nhaynes84/murmur/cad/back-pass2.png

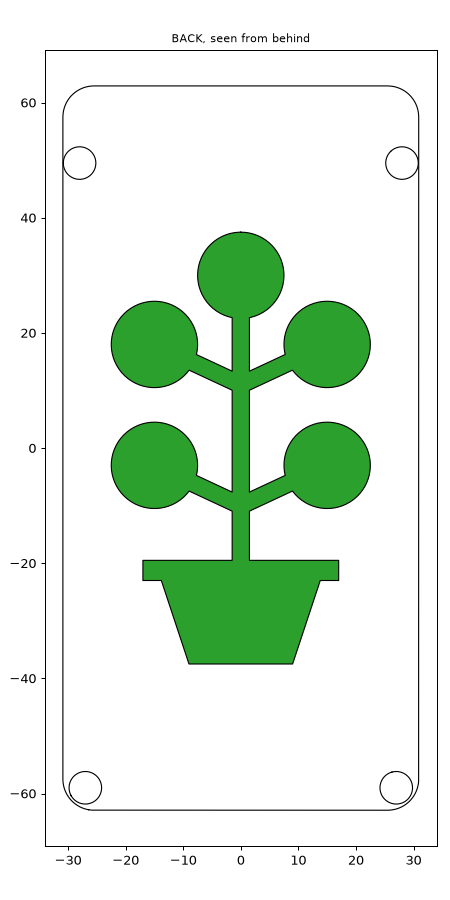
cad/back-pass2.png
