nhaynes84/murmur/cad/face-pass2.png

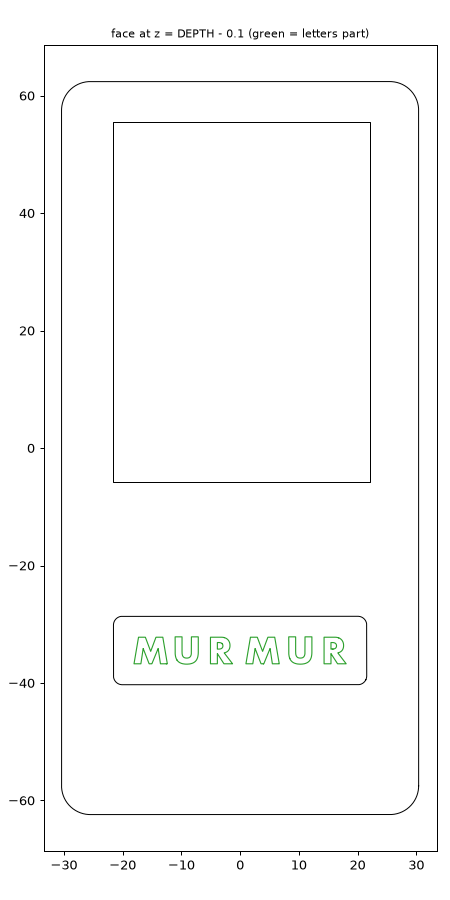
cad/face-pass2.png
