nhaynes84/murmur/cad/plan-pass2.png

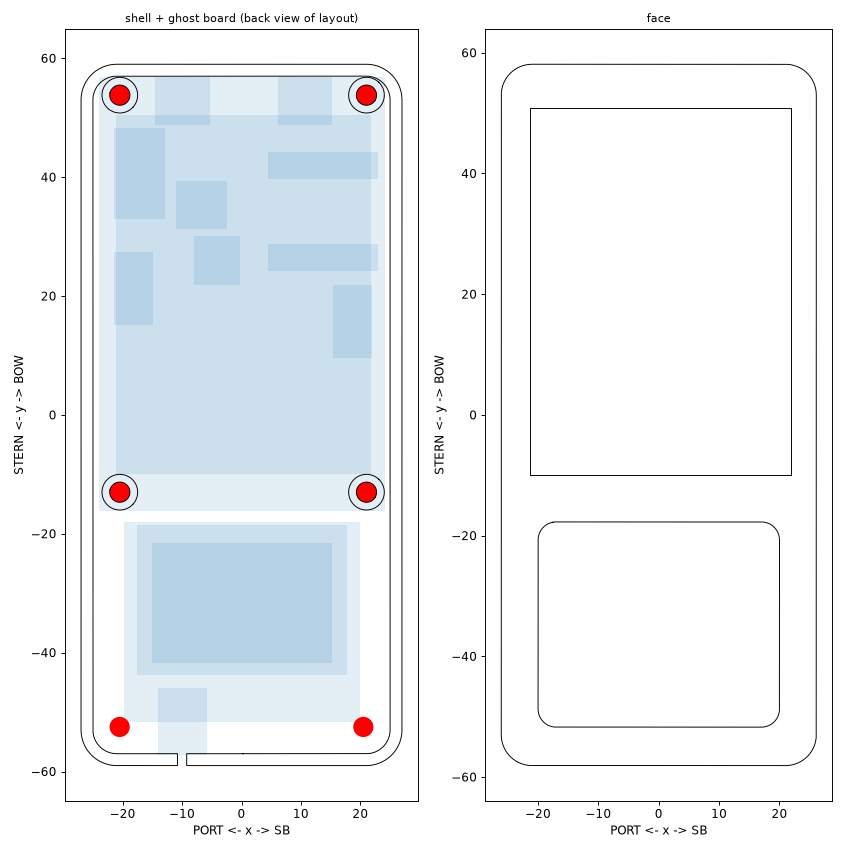
cad/plan-pass2.png
