nhaynes84/murmur/cad/port-pass2.png

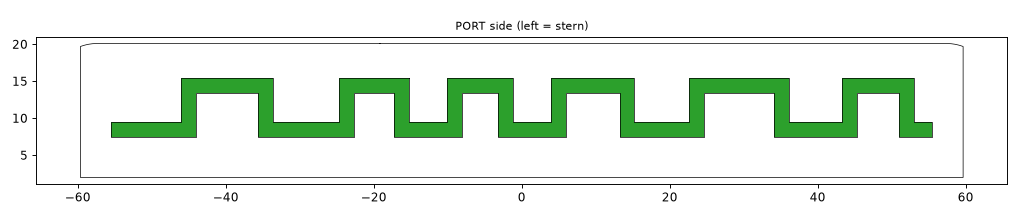
cad/port-pass2.png
