nhaynes84/murmur/cad/sides-pass2.png

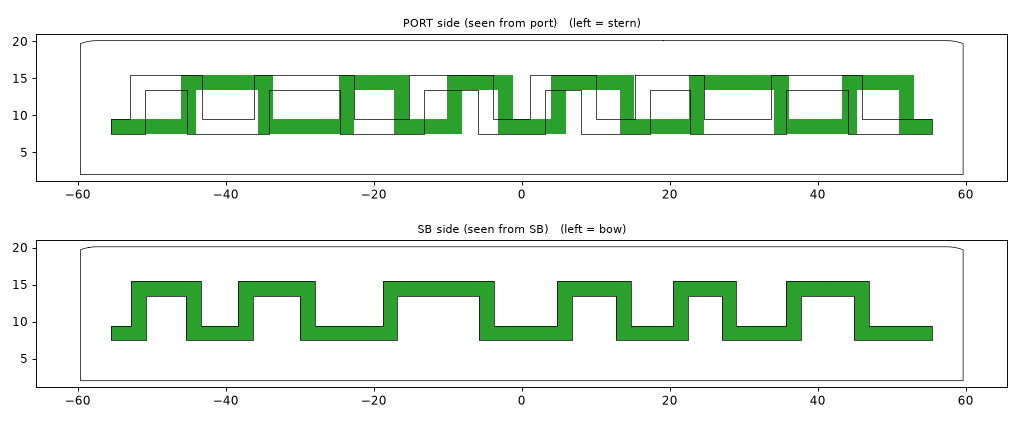
cad/sides-pass2.png
