nhaynes84/murmur/docs/murmur-schematic.png

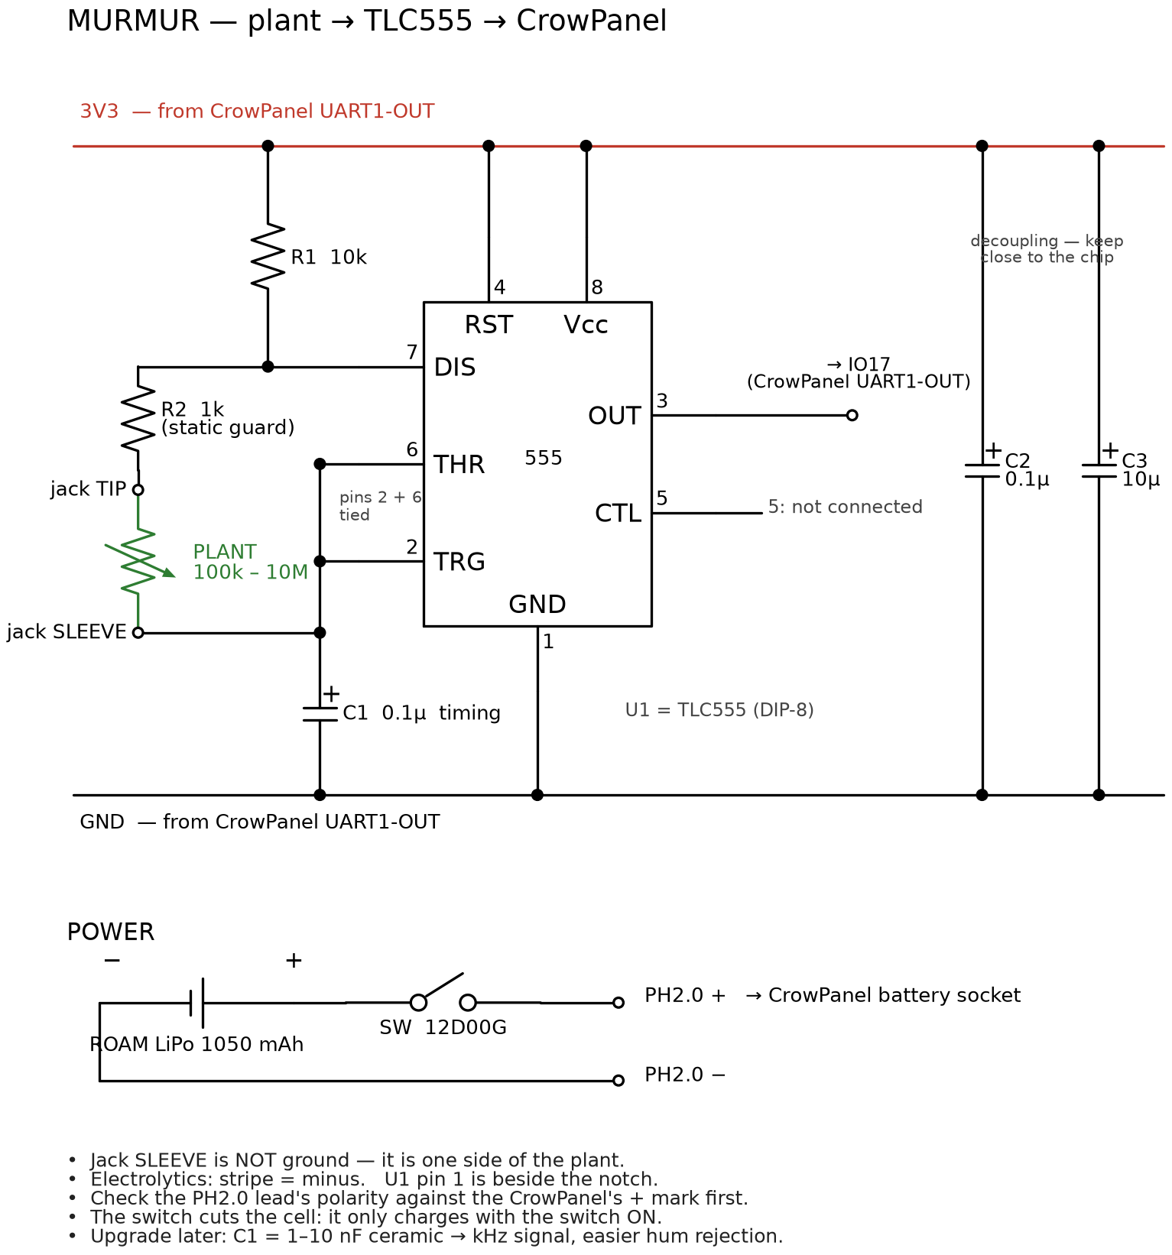
docs/murmur-schematic.png
