nhaynes84/murmur/docs/screens/main.png

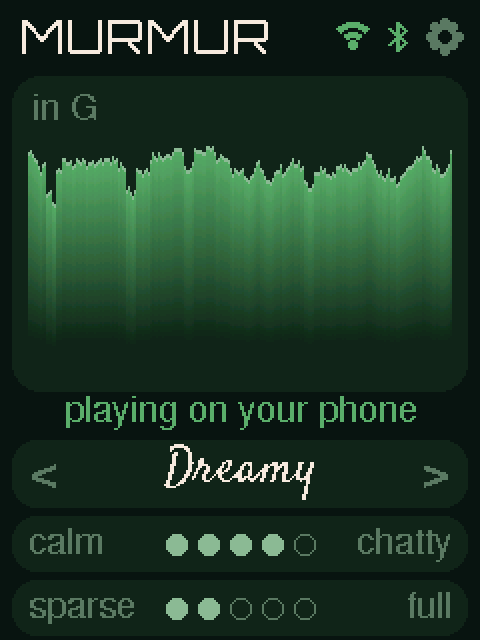
docs/screens/main.png
