nhaynes84/murmur/prints/murmur-body.step

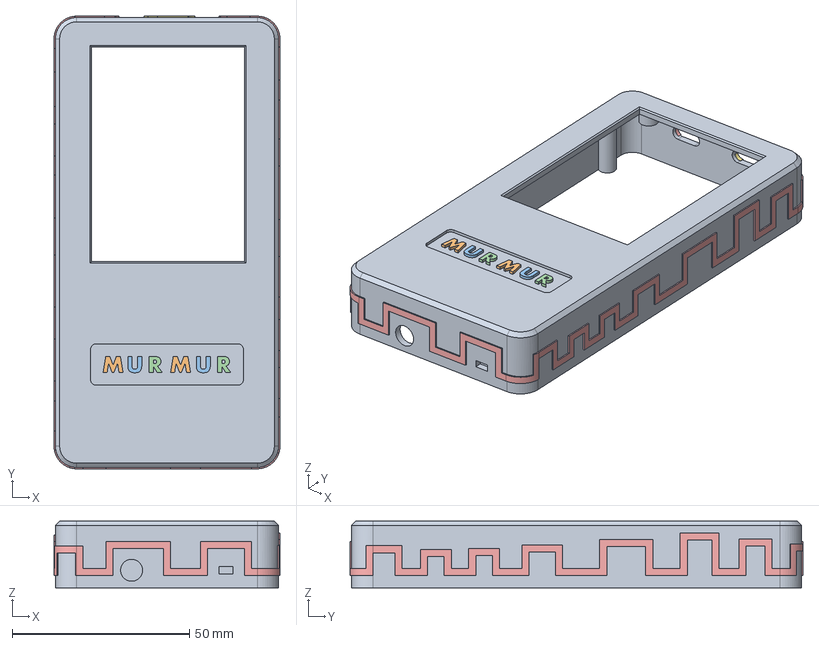
[picture p12: CAD file, 2026-11-04]
prints/murmur-body.step
63.8 x 127.8 x 18.9 mm
