nhaynes84/murmur/prints/murmur-backplate.stl

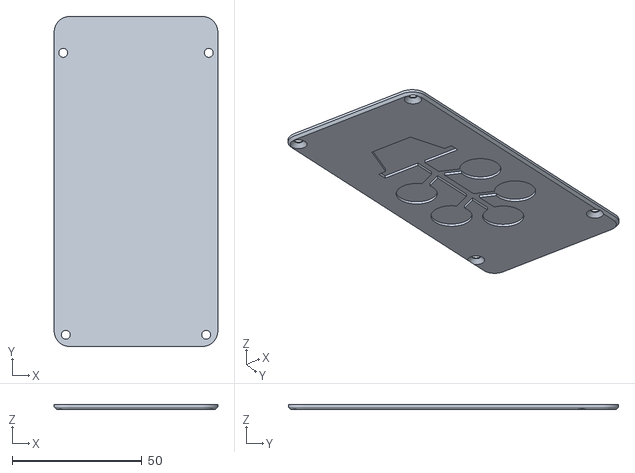
[picture p13: CAD file, 2026-11-04]
prints/murmur-backplate.stl
63.0 x 127.0 x 2.00
