nhaynes84/murmur/prints/murmur-badge-plate.step

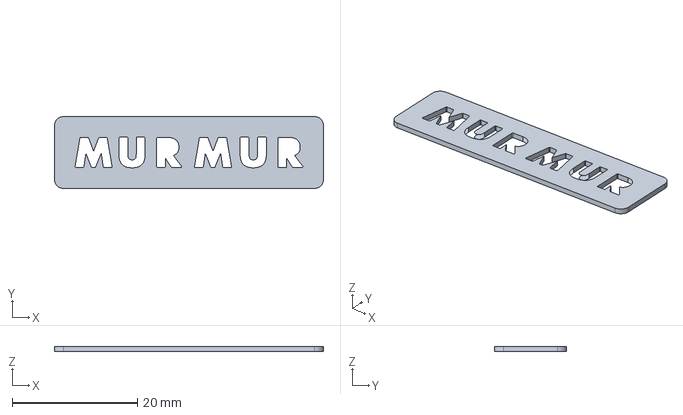
[picture p14: CAD file, 2026-11-04]
prints/murmur-badge-plate.step
42.9 x 11.5 x 0.8 mm
