nhaynes84/murmur/prints/murmur-plant.stl

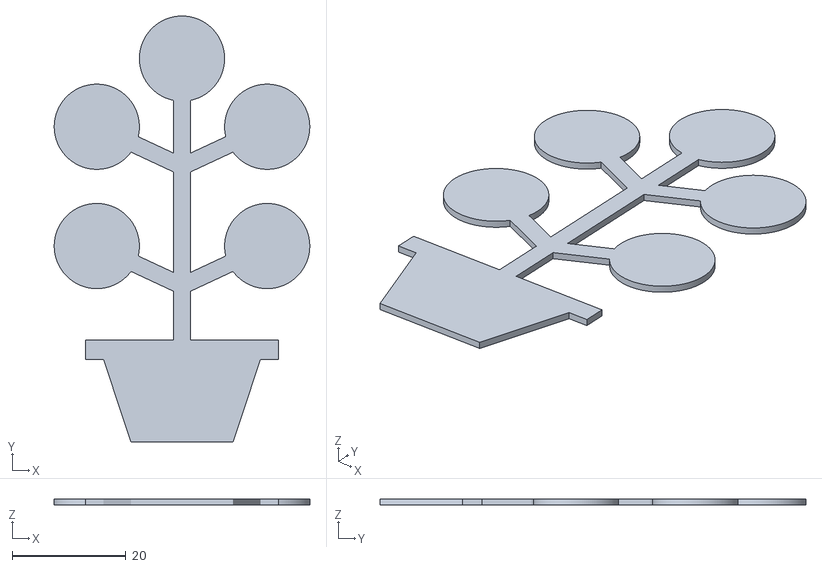
[picture p15: CAD file, 2026-11-04]
prints/murmur-plant.stl
45.0 x 75.0 x 1.00
