nhaynes84/murmur/(list of files, cad)

Other CAD files:
prints/murmur-badge-plate.stl
