nhaynes84/murmur/(commit log)

2026-11-04 MURMUR: a plant-played MIDI box — firmware, CAD, wiring, BOM
    [murmur-backplate.stl, murmur-badge-plate.step, murmur-badge-plate.stl, murmur-body.step, murmur-plant.stl]
2026-11-05 firmware: jitter noise floor, calmer chatty, time-based wave scroll, tap the wave for its speed
    [murmur.ino]
